cernohorsky/Modules/CommRF/RFM95W01A/Arduino_Mini.pdf

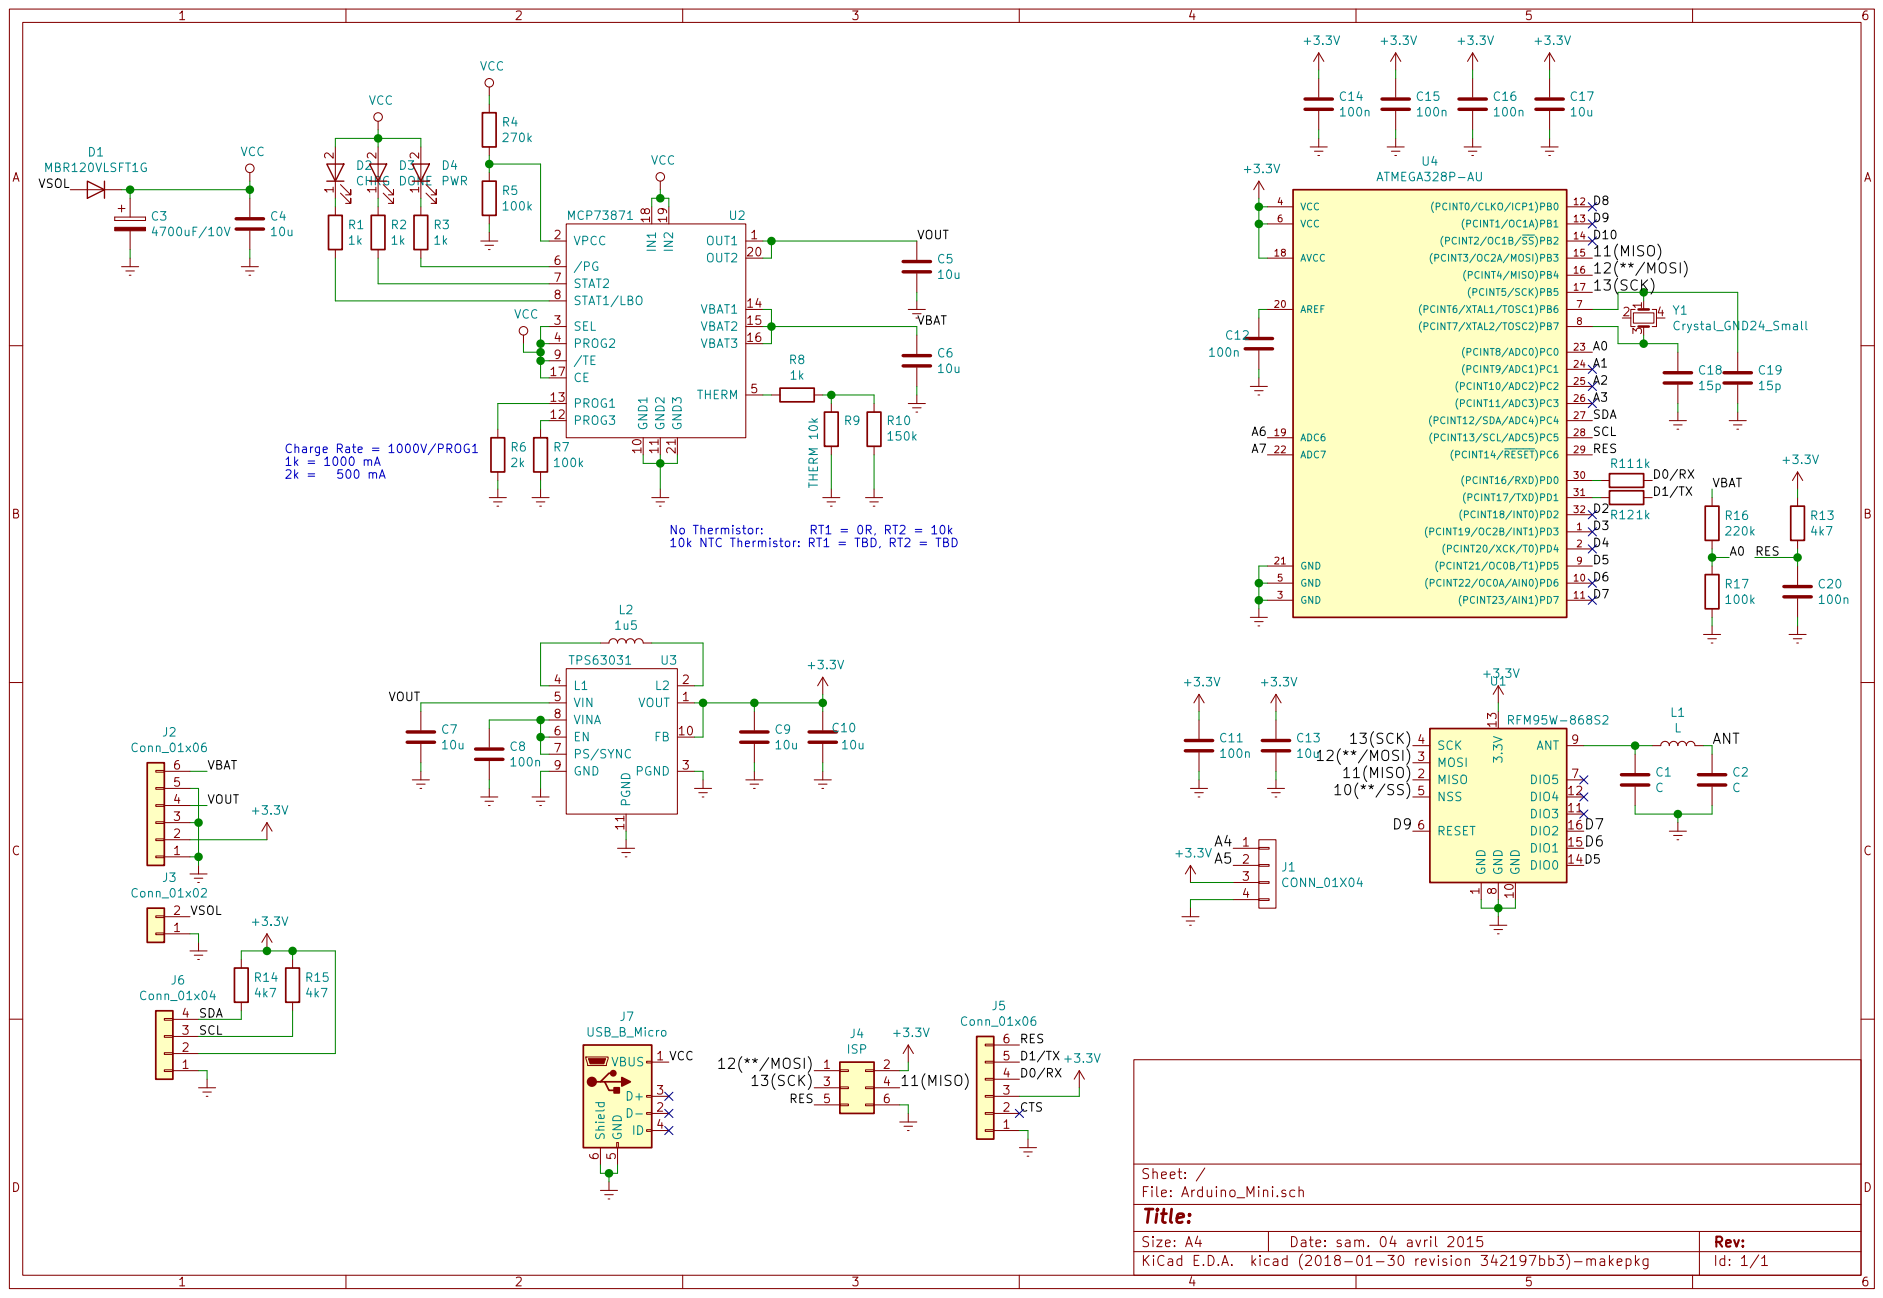
[picture p1: page 1]

1 GND 10 DIO3 11 DIO4 12 3.3V 13 DIO0 14 DIO1 15 DIO2 16 MISO 2 MOSI 3 SCK 4 NSS 5 RESET 6 DIO5 7 GND
