cernohorsky/Modules/Clock/NixieClock01A/NixieClock01A.kicad_pcb

## KiCad design Clock/NixieClock01A/NixieClock01A.kicad_pcb (2018-06-16)

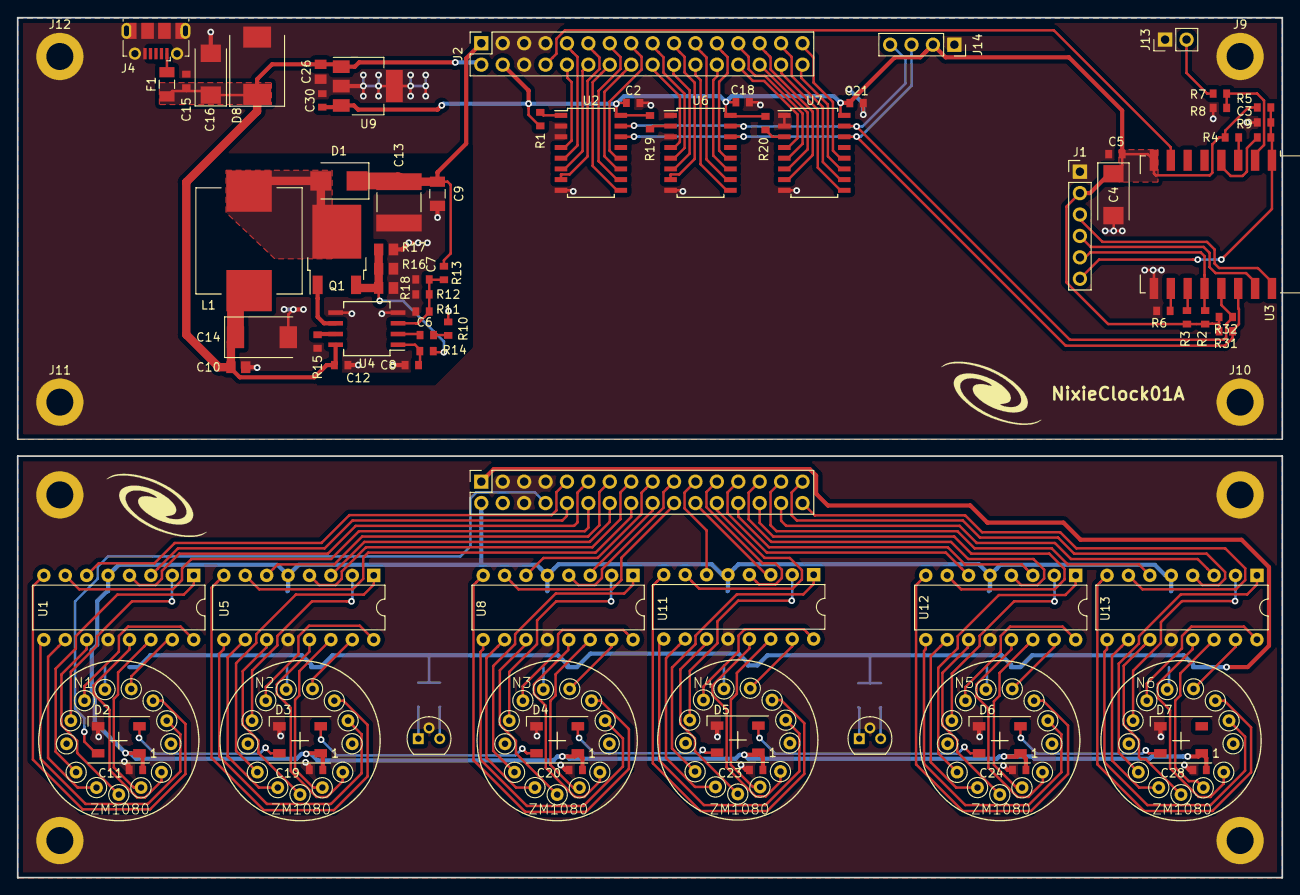
[picture p2: board NixieClock01A.kicad_pcb from above]

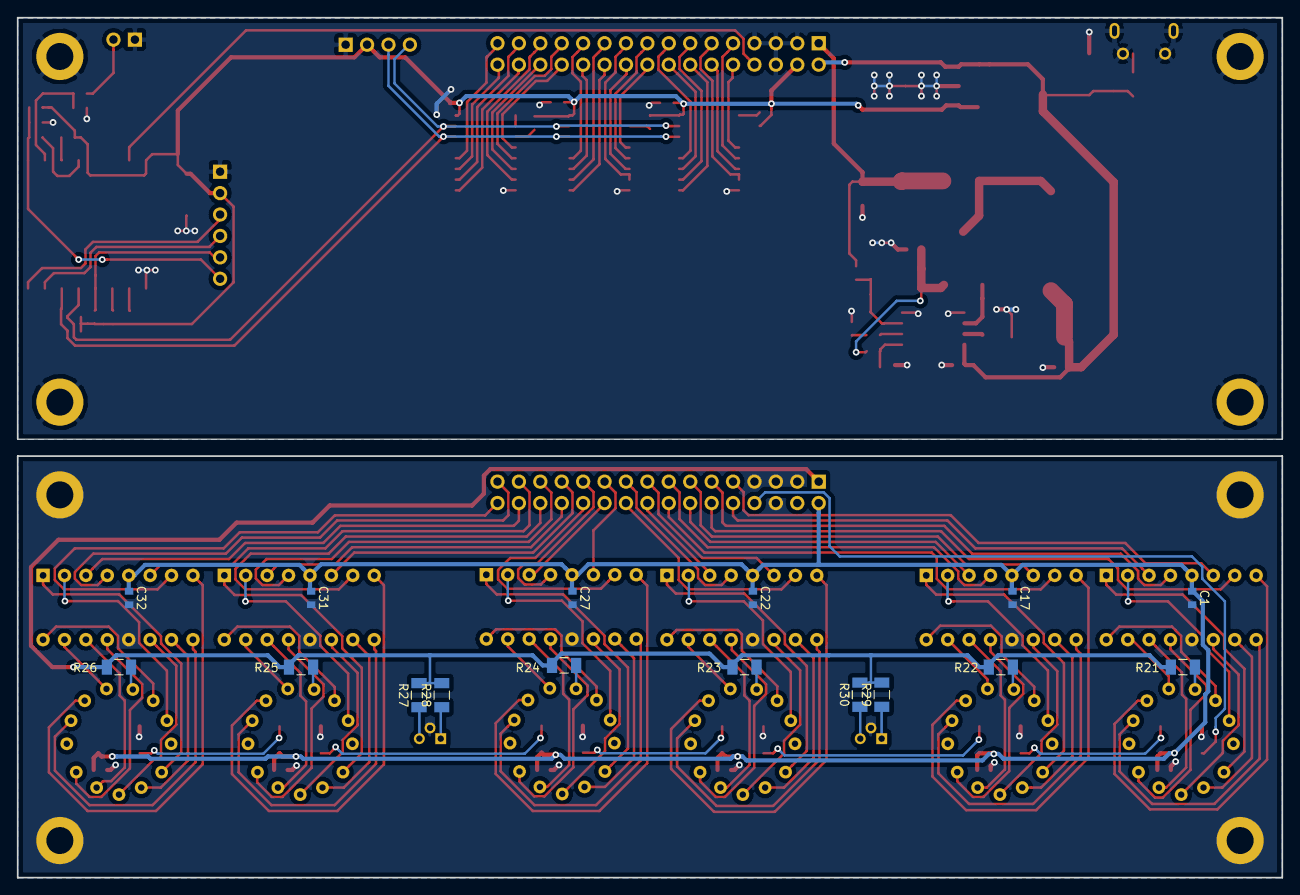
[picture p3: board NixieClock01A.kicad_pcb from below]

Board: 2 copper layers, 150.0 x 102.0 mm, 107 parts (16 on the bottom side), 128 nets.

Parts:
C1, C2, C3, C5, C11, C12, C15, C17, C18, C19, C20, C21, C22, C23, C24, C27, C28, C31, C32: 100n; C_0603_1608Metric
C4, C16: TPSC107K010R0075; CP_EIA-6032-28_Kemet-C
C6, C7: 22n; C_0603_1608Metric
C8: C; C_0603_1608Metric
C9: 100n/200V; C_1206_3216Metric
C10, C26: 10u; C_0805_2012Metric
C13: 1u/200V; C_2220_5650Metric
C14: 100u; CP_EIA-7343-31_Kemet-D
C30: 1u; C_0603_1608Metric
D1: D_Schottky; D_SMB
D2, D3, D4, D5, D6, D7: WS2812B; LED_WS2812B_PLCC4_5.0x5.0mm_P3.2mm
D8: D_TVS; D_SMC
F1: Fuse; Fuse_1206_3216Metric
J1: Conn_01x06_Male; PinHeader_1x06_P2.54mm_Vertical
J2, J3: Conn_02x16_Odd_Even; PinSocket_2x16_P2.54mm_Vertical
J4: USB_B_Micro; USB_Micro-B_Molex-105017-0001
J5, J6, J7, J8, J9, J10, J11, J12: Conn_01x01_Male; MountingHole_3.2mm_M3_DIN965_Pad
J13: Conn_01x02_Male; PinHeader_1x02_P2.54mm_Vertical
J14: Conn_01x04_Male; PinSocket_1x04_P2.54mm_Vertical
L1: L_Core_Ferrite; L_Wuerth_WE-PD-Typ-LS_Handsoldering
LA1, LA2: Lamp_Neon; TO-92
N1, N2, N3, N4, N5, N6: ZM1080
Q1: Q_NMOS_GDS; TO-252-2
R1, R11, R12, R13, R14, R19, R20: R; R_0603_1608Metric
R2, R3, R4, R5, R6: 12k; R_0603_1608Metric
R7: 330k; R_0603_1608Metric
R8: 100k; R_0603_1608Metric
R9: 470R; R_0603_1608Metric
R10: 4k7; R_0603_1608Metric
R15: 40k; R_0603_1608Metric
R16, R17, R18: R; R_0805_2012Metric
R21, R22, R23, R24, R25, R26: 27k; R_1206_3216Metric
R27, R28, R29, R30: 1M; R_1206_3216Metric
R31, R32: 4K7; R_0603_1608Metric
U1, U5, U8, U11, U12, U13: 74141; DIP-16_W7.62mm
U2, U6, U7: PCF8574; SOIC-16W_5.3x10.2mm_P1.27mm
U3: ESP-12E
U4: LM3478; SO-8_5.3x6.2mm_P1.27mm
U9: TC1262-33; SOT-223

Connections:
+3V3: C2.1, C4.1, C5.1, C18.1, C21.1, C30.1, J1.2, J2.4, J3.4, J14.2, R1.1, R2.2, R3.2, R4.2, R5.2, R19.1, R20.1, R31.2, R32.2, U2.16, U3.8, U6.16, U7.16, U9.3
+5V: C1.1, C10.1, C11.1, C12.1, C14.1, C15.1, C16.1, C17.1, C19.1, C20.1, C22.1, C23.1, C24.1, C26.1, C27.1, C28.1, C31.1, C32.1, D2.1, D3.1, D4.1, D5.1, D6.1, D7.1, D8.1, F1.1, J2.2, J3.2, L1.1, U1.5, U4.8, U5.5, U8.5, U9.1, U11.5, U12.5, U13.5
/A1: J2.10, J3.10, U1.3, U2.4
/A2: J2.9, J3.9, U1.6, U2.5
/A3: J2.12, J3.12, U1.7, U2.6
/A4: J2.11, J3.11, U1.4, U2.7
/ADC: R7.2, R8.1, U3.2
/ADC-IN: J13.2, R7.1
/B1: J2.14, J3.14, U2.9, U5.3
/B2: J2.13, J3.13, U2.10, U5.6
/B3: J2.16, J3.16, U2.11, U5.7
/B4: J2.15, J3.15, U2.12, U5.4
/C1: J2.18, J3.18, U6.4, U8.3
/C2: J2.17, J3.17, U6.5, U8.6
/C3: J2.20, J3.20, U6.6, U8.7
/C4: J2.19, J3.19, U6.7, U8.4
/D1: J2.22, J3.22, U6.9, U11.3
/D2: J2.21, J3.21, U6.10, U11.6
/D3: J2.24, J3.24, U6.11, U11.7
/D4: J2.23, J3.23, U6.12, U11.4
/E1: J2.26, J3.26, U7.4, U12.3
/E2: J2.25, J3.25, U7.5, U12.6
/E3: J2.28, J3.28, U7.6, U12.7
/E4: J2.27, J3.27, U7.7, U12.4
/EN: R4.1, U3.3
/F1: J2.30, J3.30, U7.9, U13.3
/F2: J2.29, J3.29, U7.10, U13.6
/F3: J2.32, J3.32, U7.11, U13.7
/F4: J2.31, J3.31, U7.12, U13.4
/GPIO0: J1.5, R2.1, U3.18
/GPIO2: R3.1, U3.17
/GPIO15: R6.1, U3.16
/NeoPix: D2.4, J2.8, J3.8, U3.7
/RST: C3.1, J1.6, R5.1, R9.1, U3.1
/RX: J1.4, U3.21
/SCL: J14.3, R31.1, U2.14, U3.20, U6.14, U7.14
/SDA: J14.4, R32.1, U2.15, U3.19, U6.15, U7.15
/TX: J1.3, U3.22
/Uanode: C9.1, C13.1, D1.1, J2.1, J3.1, R13.1, R21.1, R22.1, R23.1, R24.1, R25.1, R26.1, R27.2, R28.2, R29.2, R30.2
GND: C1.2, C2.2, C3.2, C4.2, C5.2, C7.1, C8.1, C9.2, C10.2, C11.2, C12.2, C13.2, C14.2, C15.2, C16.2, C17.2, C18.2, C19.2, C20.2, C21.2, C22.2, C23.2, C24.2, C26.2, C27.2, C28.2, C30.2, C31.2, C32.2, D2.3, D3.3, D4.3, D5.3, D6.3, D7.3, D8.2, J1.1, J2.3, J2.5, J2.6, J2.7, J3.3, J3.5, J3.6, J3.7, J4.5, J4.6, J5.1, J6.1, J7.1, J8.1, J9.1, J10.1, J11.1, J12.1, J13.1, J14.1, LA1.2, LA2.2, R6.2, R8.2, R10.1, R11.1, R12.1, R15.2, R16.2, R17.2, R18.2, U1.12, U2.2, U2.3, U2.8, U3.15, U4.4, U4.5, U5.12, U6.1, U6.3, U6.8, U7.1, U7.2, U7.8, U8.12, U9.2, U9.4, U11.12, U12.12, U13.12
unnamed: C6.1, U4.2
unnamed: C6.2, R10.2
unnamed: C7.2, R11.2, R12.2, R13.2, U4.3
unnamed: C8.2, R14.2, U4.1
unnamed: D1.2, L1.2, Q1.2
unnamed: D2.2, D3.4
unnamed: D3.2, D4.4
unnamed: D4.2, D5.4
unnamed: D5.2, D6.4
unnamed: D6.2, D7.4
unnamed: F1.2, J4.1
unnamed: LA1.1, R28.1
unnamed: LA1.3, R27.1
unnamed: LA2.1, R29.1
unnamed: LA2.3, R30.1
unnamed: N1.1, U1.15
unnamed: N1.2, U1.8
unnamed: N1.3, U1.9
unnamed: N1.5, U1.13
unnamed: N1.6, U1.14
unnamed: N1.7, U1.11
unnamed: N1.8, U1.10
unnamed: N1.9, U1.1
unnamed: N1.11, U1.2
unnamed: N1.12, U1.16
unnamed: N1.13, R21.2
unnamed: N2.1, U5.15
unnamed: N2.2, U5.8
unnamed: N2.3, U5.9
unnamed: N2.5, U5.13
unnamed: N2.6, U5.14
unnamed: N2.7, U5.11
unnamed: N2.8, U5.10
unnamed: N2.9, U5.1
unnamed: N2.11, U5.2
unnamed: N2.12, U5.16
unnamed: N2.13, R22.2
unnamed: N3.1, U8.15
unnamed: N3.2, U8.8
unnamed: N3.3, U8.9
unnamed: N3.5, U8.13
unnamed: N3.6, U8.14
unnamed: N3.7, U8.11
unnamed: N3.8, U8.10
unnamed: N3.9, U8.1
unnamed: N3.11, U8.2
unnamed: N3.12, U8.16
unnamed: N3.13, R23.2
unnamed: N4.1, U11.15
unnamed: N4.2, U11.8
unnamed: N4.3, U11.9
unnamed: N4.5, U11.13
unnamed: N4.6, U11.14
unnamed: N4.7, U11.11
unnamed: N4.8, U11.10
unnamed: N4.9, U11.1
unnamed: N4.11, U11.2
unnamed: N4.12, U11.16
unnamed: N4.13, R24.2
unnamed: N5.1, U12.15
unnamed: N5.2, U12.8
unnamed: N5.3, U12.9
unnamed: N5.5, U12.13
unnamed: N5.6, U12.14
unnamed: N5.7, U12.11
unnamed: N5.8, U12.10
unnamed: N5.9, U12.1
unnamed: N5.11, U12.2
unnamed: N5.12, U12.16
unnamed: N5.13, R25.2
unnamed: N6.1, U13.15
unnamed: N6.2, U13.8
unnamed: N6.3, U13.9
unnamed: N6.5, U13.13
unnamed: N6.6, U13.14
unnamed: N6.7, U13.11
unnamed: N6.8, U13.10
unnamed: N6.9, U13.1
unnamed: N6.11, U13.2
unnamed: N6.12, U13.16
unnamed: N6.13, R26.2
unnamed: Q1.1, U4.6
unnamed: Q1.3, R14.1, R16.1, R17.1, R18.1
unnamed: R1.2, U2.1
unnamed: R9.2, U3.4
unnamed: R15.1, U4.7
unnamed: R19.2, U6.2
unnamed: R20.2, U7.3
