cernohorsky/Modules/CommRF/ESP826601A/ESP8266.kicad_pcb

## KiCad design CommRF/ESP826601A/ESP8266.kicad_pcb (2018-06-09)

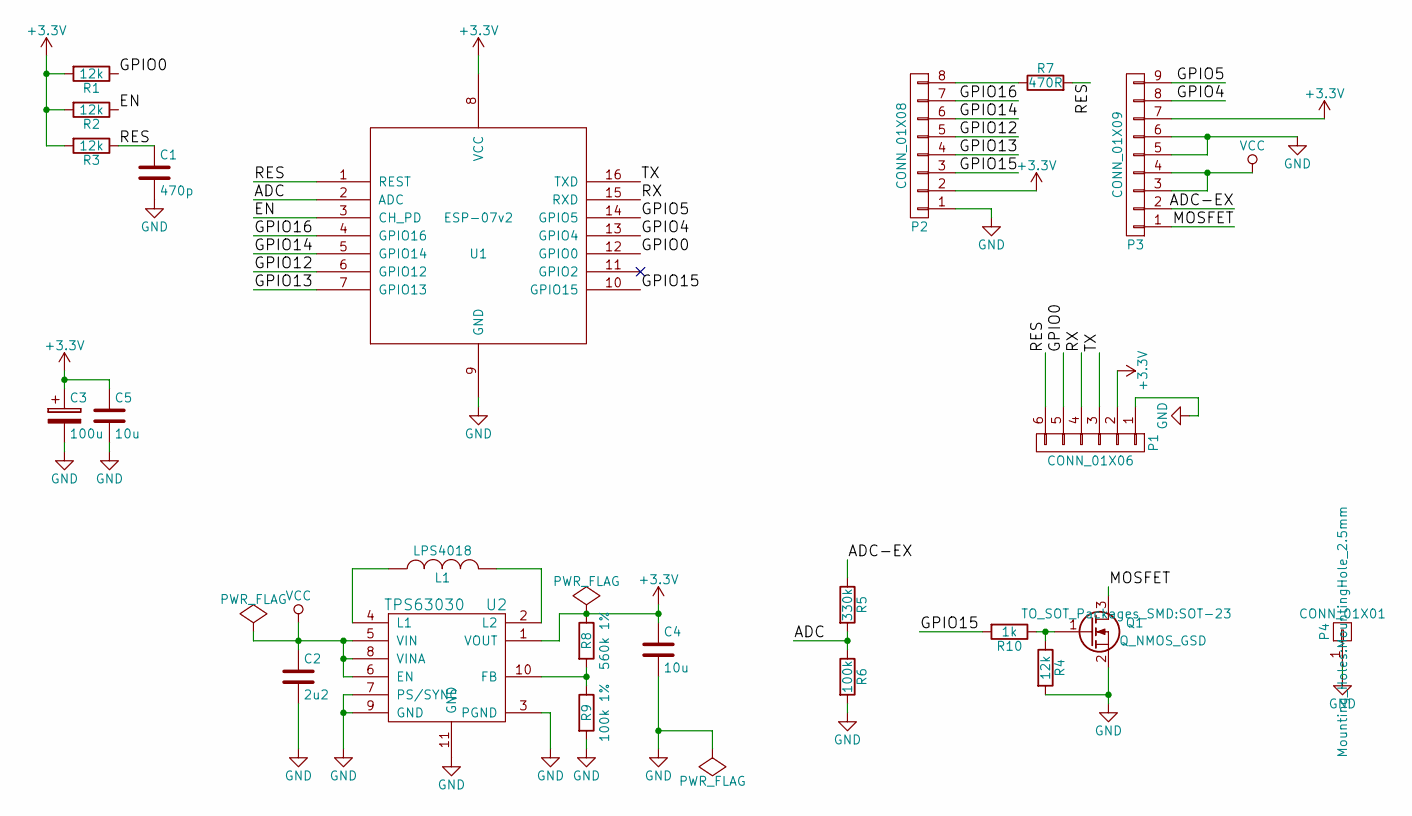
[picture p4: schematic ESP8266.sch]

Parts:
C1: 470p; C_0603
C2: 2u2; C_0603
C3: 100u; TantalC_SizeB_EIA-3528_Wave
C4, C5: 10u; C_0805
L1: LPS4018
P1: CONN_01X06; Pin_Header_Straight_1x06
P2: CONN_01X08; Pin_Header_Straight_1x08
P3: CONN_01X09; Pin_Header_Straight_1x09
P4: CONN_01X01; MountingHole_2.5mm
Q1: Q_NMOS_GSD; SOT-23
R1, R2, R3, R4: 12k; R_0603
R5: 330k; R_0603
R6: 100k; R_0603
R7: 470R; R_0603
R8: 560k 1%; R_0603
R9: 100k 1%; R_0603
R10: 1k; R_0603
U1: ESP-07v2
U2: TPS63030; DSK-10Pin-VSON

Connections:
+3V3: C3.1, C4.1, C5.1, P1.2, P2.2, P3.7, R1.2, R2.2, R3.2, R8.1, U1.8 (VCC), U2.1 (VOUT)
/ADC: R5.2, R6.1, U1.2 (ADC)
/ADC-EX: P3.2, R5.1
/EN: R2.1, U1.3 (CH_PD)
/GPIO0: P1.5, R1.1, U1.12 (GPIO0)
/GPIO4: P3.8, U1.13 (GPIO4)
/GPIO5: P3.9, U1.14 (GPIO5)
/GPIO12: P2.5, U1.6 (GPIO12)
/GPIO13: P2.4, U1.7 (GPIO13)
/GPIO14: P2.6, U1.5 (GPIO14)
/GPIO15: P2.3, R10.2, U1.10 (GPIO15)
/GPIO16: P2.7, U1.4 (GPIO16)
/MOSFET: P3.1, Q1.3 (D)
/RES: C1.1, P1.6, R3.1, R7.2, U1.1 (REST)
/RX: P1.4, U1.15 (RXD)
/TX: P1.3, U1.16 (TXD)
GND: C1.2, C2.2, C3.2, C4.2, C5.2, P1.1, P2.1, P3.5, P3.6, P4.1, Q1.2 (S), R4.2, R6.2, R9.2, U1.9 (GND), U2.3 (PGND), U2.7 (PS/SYNC), U2.9 (GND), U2.11 (GND)
unnamed: L1.1, U2.4 (L1)
unnamed: L1.2, U2.2 (L2)
unnamed: P2.8, R7.1
unnamed: Q1.1 (G), R4.1, R10.1
unnamed: R8.2, R9.1, U2.10 (FB)
VCC: C2.1, P3.3, P3.4, U2.5 (VIN), U2.6 (EN), U2.8 (VINA)

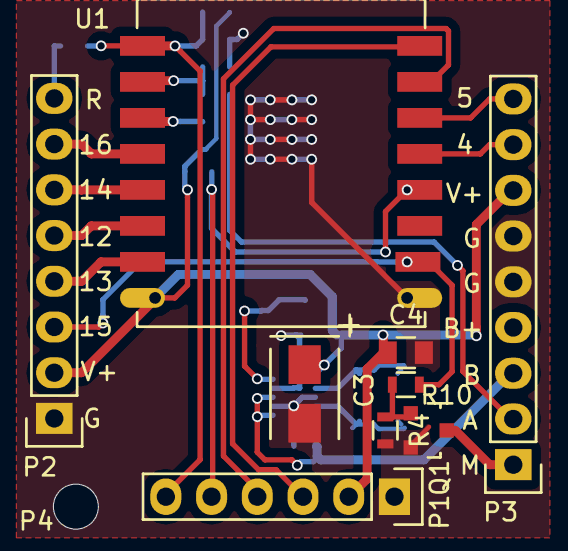
[picture p5: board ESP8266.kicad_pcb from above]

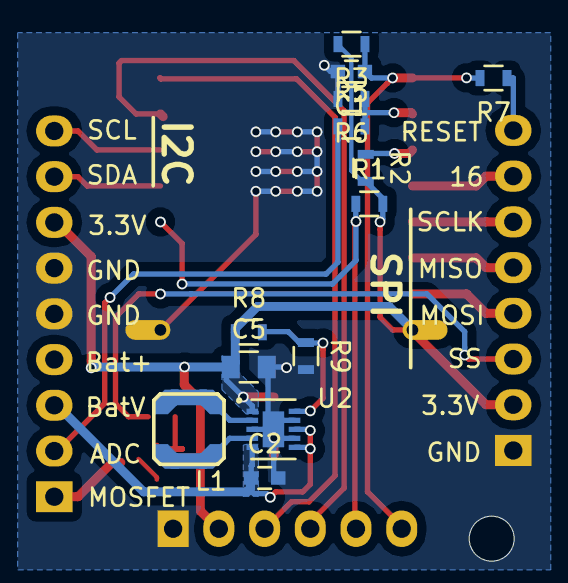
[picture p6: board ESP8266.kicad_pcb from below]

Board: 2 copper layers, 23 parts (13 on the bottom side), 23 nets.
