cernohorsky/Modules/PowerSupply/LMR1405001A/LMR1405001A.kicad_pcb

## KiCad design PowerSupply/LMR1405001A/LMR1405001A.kicad_pcb (2018-01-28)

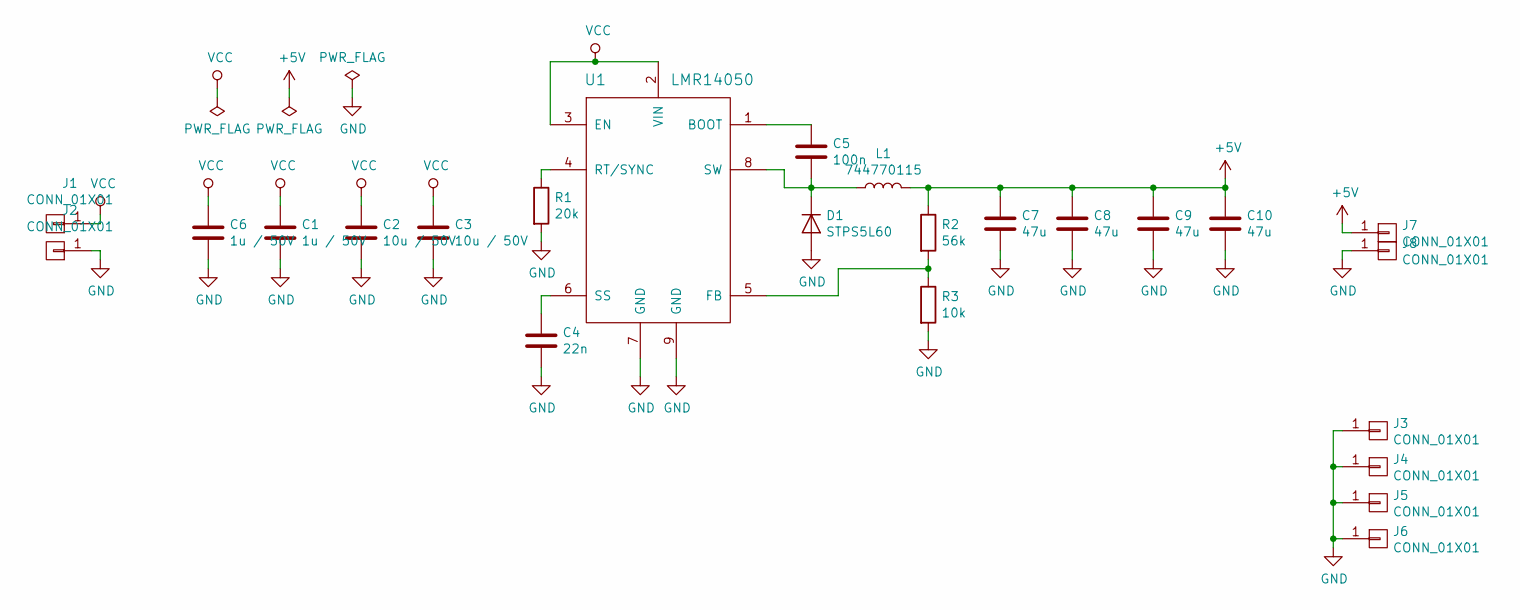
[picture p7: schematic LMR1405001A.sch]

Parts:
C1, C6: 1u / 50V; C_1210
C2, C3: 10u / 50V; C_1210
C4: 22n; C_0603
C5: 100n; C_0603
C7, C8, C9, C10: 47u; C_1210
D1: STPS5L60; DO-214AB
J1, J2, J7, J8: CONN_01X01; WAGO256_2
J3, J4, J5, J6: CONN_01X01; MountingHole_3.2mm_M3_Pad
L1: 744770115; SELF-WE-PD-XXL
R1: 20k; C_0603
R2: 56k; C_0603
R3: 10k; C_0603
U1: LMR14050; HSOP-8

Connections:
+5V: C7.1, C8.1, C9.1, C10.1, J7.1, L1.2, R2.1
GND: C1.2, C2.2, C3.2, C4.2, C6.2, C7.2, C8.2, C9.2, C10.2, D1.2 (A), J2.1, J3.1, J4.1, J5.1, J6.1, J8.1, R1.2, R3.2, U1.7 (GND), U1.9 (GND)
unnamed: C4.1, U1.6 (SS)
unnamed: C5.1, U1.1 (BOOT)
unnamed: C5.2, D1.1 (K), L1.1, U1.8 (SW)
unnamed: R1.1, U1.4 (RT/SYNC)
unnamed: R2.2, R3.1, U1.5 (FB)
VCC: C1.1, C2.1, C3.1, C6.1, J1.1, U1.2 (VIN), U1.3 (EN)

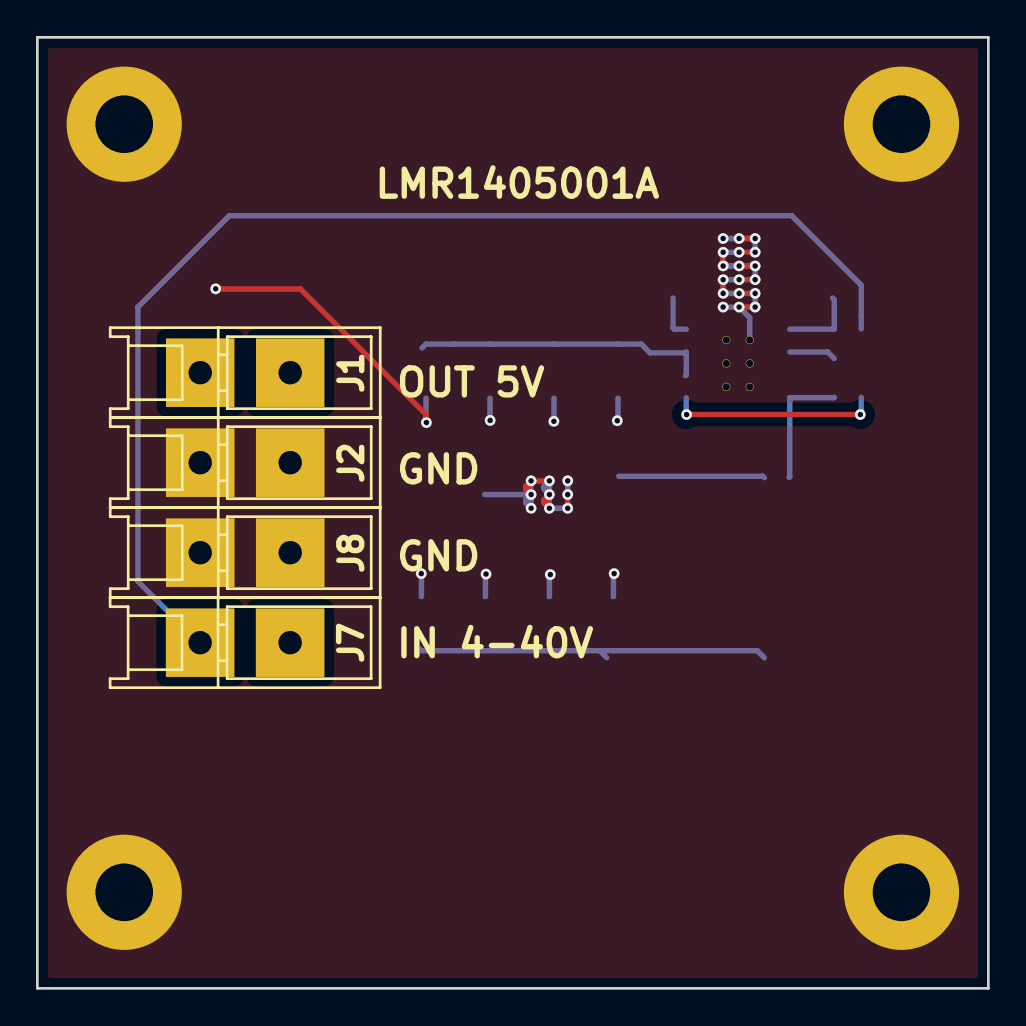
[picture p8: board LMR1405001A.kicad_pcb from above]

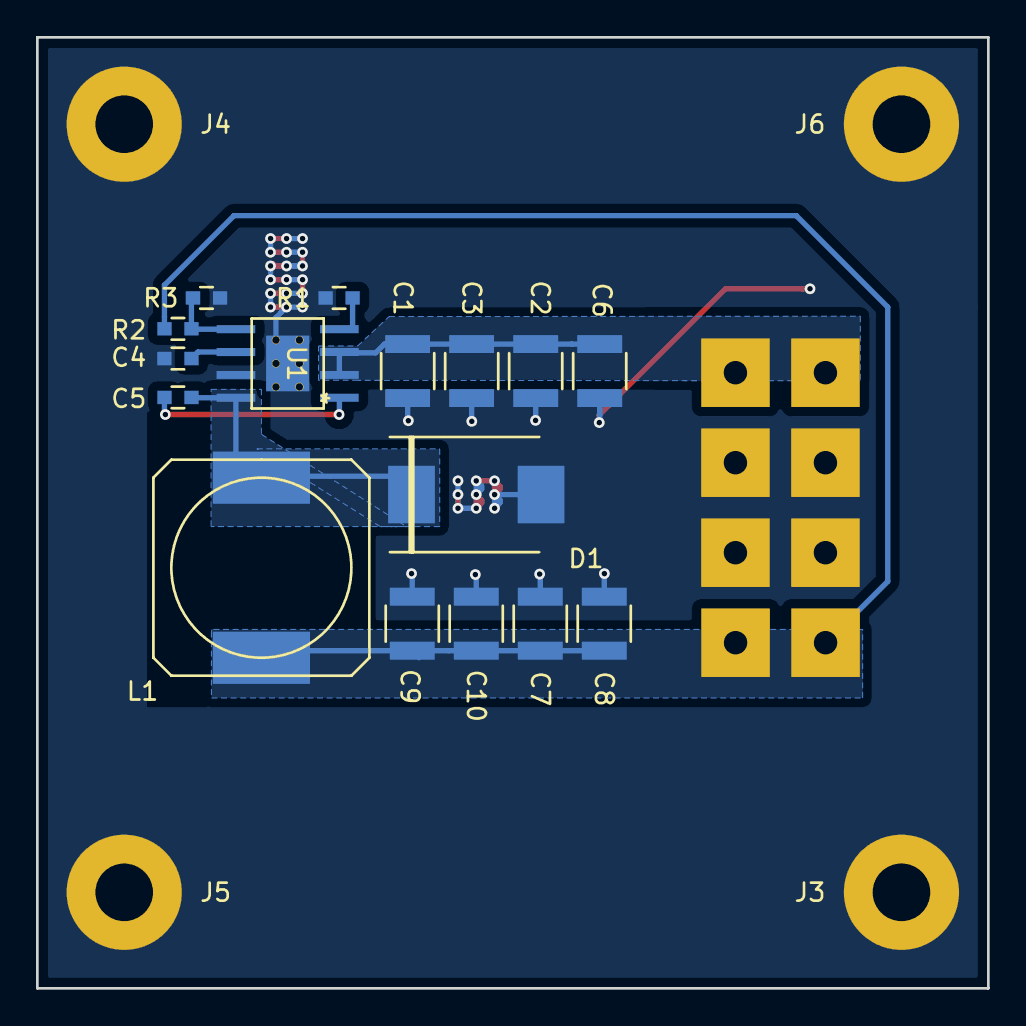
[picture p9: board LMR1405001A.kicad_pcb from below]

Board: 2 copper layers, 52.8 x 52.8 mm, 24 parts (20 on the bottom side), 8 nets.
