cernohorsky/Modules/PowerSW/BTT605001A/BTT605001A.kicad_pcb

## KiCad design PowerSW/BTT605001A/BTT605001A.kicad_pcb (2018-01-28)

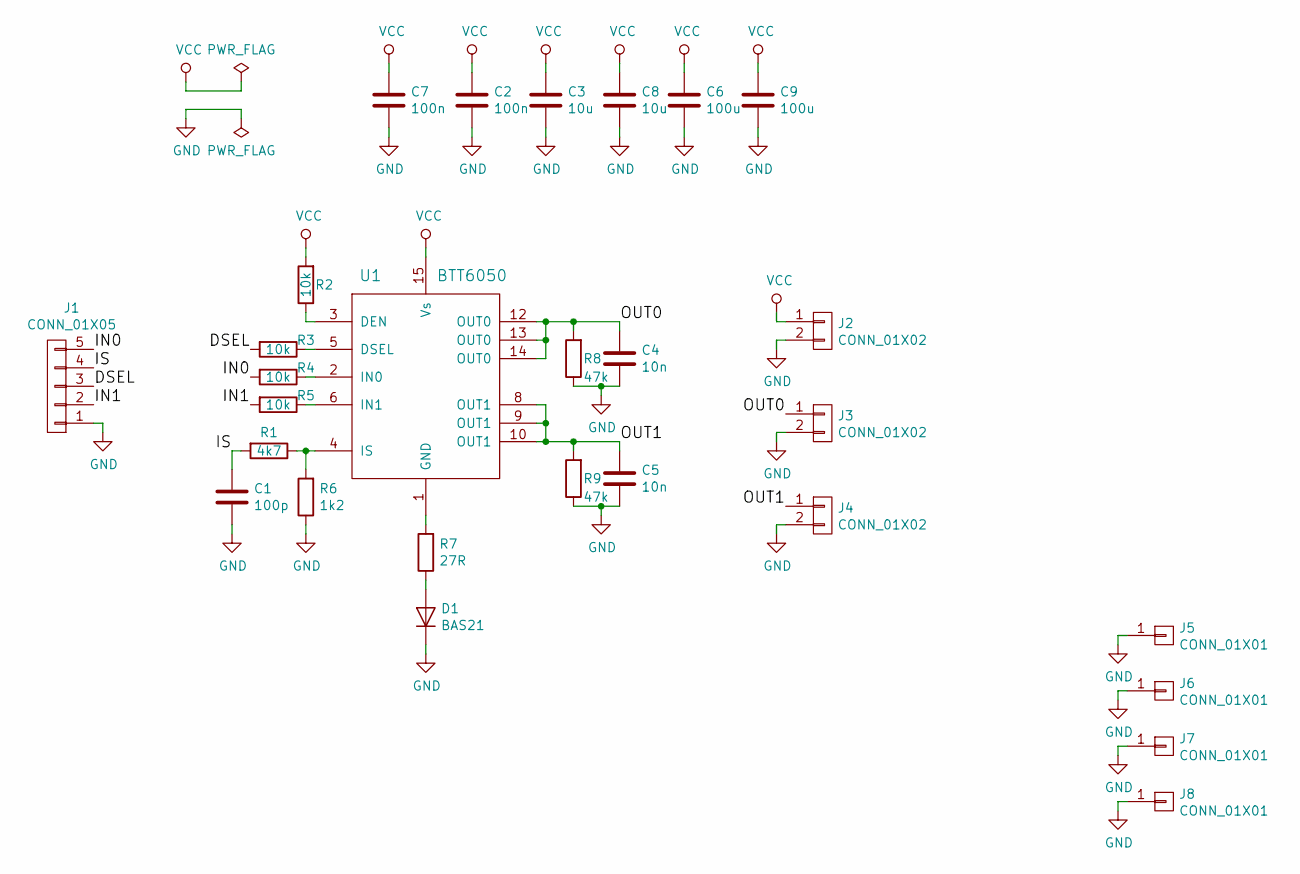
[picture p10: schematic BTT605001A.sch]

Parts:
C1: 100p; C_0603
C2, C7: 100n; C_0603
C3, C8: 10u; C_1210
C4, C5: 10n; C_0603
C6, C9: 100u; c_elec_10x10.5
D1: BAS21; C_0603
J1: CONN_01X05; Pin_Header_Straight_1x05
J2, J3, J4: CONN_01X02; WireConnection_2.50mmDrill
J5, J6, J7, J8: CONN_01X01; MountingHole_3.2mm_M3_DIN965_Pad
R1: 4k7; R_0603
R2, R3, R4, R5: 10k; R_0603
R6: 1k2; R_0603
R7: 27R; R_0603
R8, R9: 47k; R_0603
U1: BTT6050; PG-DSO-14-47_3.9x8.7mm_Pitch1.27mm

Connections:
/DSEL: J1.3, R3.2
/IN0: J1.5, R4.2
/IN1: J1.2, R5.2
/IS: C1.1, J1.4, R1.2
/OUT0: C4.1, J3.1, R8.2, U1.12 (OUT0), U1.13 (OUT0), U1.14 (OUT0)
/OUT1: C5.1, J4.1, R9.2, U1.8 (OUT1), U1.9 (OUT1), U1.10 (OUT1)
GND: C1.2, C2.2, C3.2, C4.2, C5.2, C6.2, C7.2, C8.2, C9.2, D1.1 (K), J1.1, J2.2, J3.2, J4.2, J5.1, J6.1, J7.1, J8.1, R6.1, R8.1, R9.1
unnamed: D1.2 (A), R7.1
unnamed: R1.1, R6.2, U1.4 (IS)
unnamed: R2.1, U1.3 (DEN)
unnamed: R3.1, U1.5 (DSEL)
unnamed: R4.1, U1.2 (IN0)
unnamed: R5.1, U1.6 (IN1)
unnamed: R7.2, U1.1 (GND)
VCC: C2.1, C3.1, C6.1, C7.1, C8.1, C9.1, J2.1, R2.2, U1.15 (Vs)

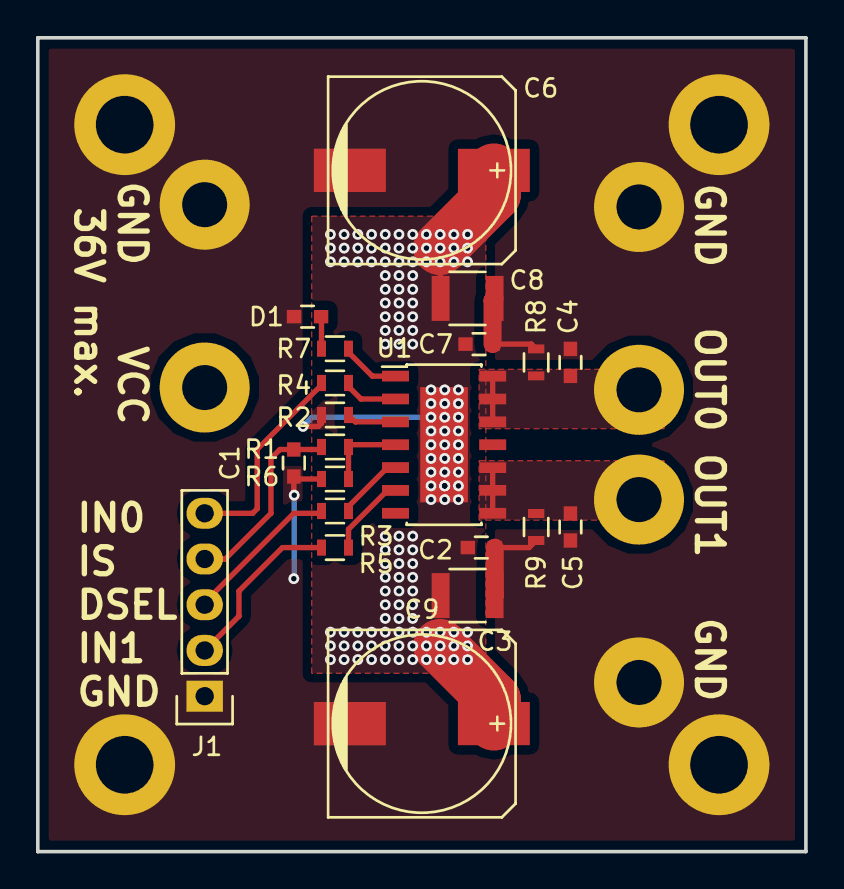
[picture p11: board BTT605001A.kicad_pcb from above]

Board: 2 copper layers, 42.7 x 45.2 mm, 28 parts (0 on the bottom side), 15 nets.
