cernohorsky/Modules/H_Bridge/LM5104-IRFZ44N01A/LM510401A.kicad_pcb

## KiCad design H_Bridge/LM5104-IRFZ44N01A/LM510401A.kicad_pcb (2018-01-28)

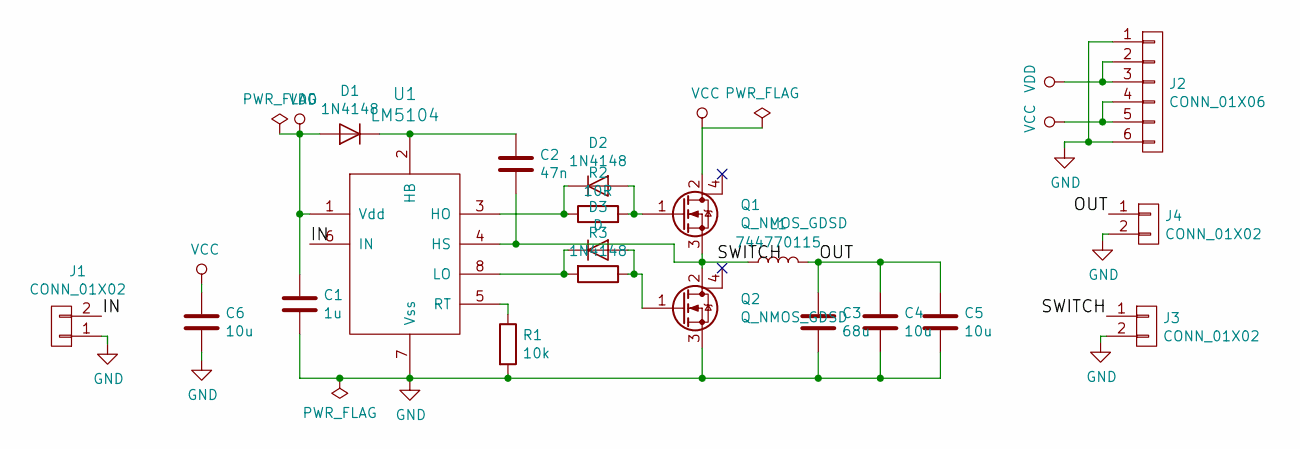
[picture p12: schematic LM510401A.sch]

Parts:
C1: 1u; C_0805
C2: 47n; C_0603
C3: 68u; C_1210
C4, C5, C6: 10u; C_1210
D1, D2: 1N4148; C_0603
D3: D; C_0603
J1, J3, J4: CONN_01X02; Pin_Header_Straight_1x02
J2: CONN_01X06; Pin_Header_Straight_1x06
L1: 744770115; SELF-WE-PD-XXL
Q1, Q2: Q_NMOS_GDSD; TO-220_Neutral123_Vertical
R1: 10k; R_0603
R2: 10R; R_0603
R3: 1N4148; R_0603
U1: LM5104; SOIC-8-N

Connections:
/IN: J1.2, U1.6 (IN)
/OUT: C3.1, C4.1, C5.1, J4.1, L1.2
/SWITCH: C2.2, J3.1, L1.1, Q1.3 (S), Q2.2 (D), U1.4 (HS)
GND: C1.2, C3.2, C4.2, C5.2, C6.2, J1.1, J2.1, J2.6, J3.2, J4.2, Q2.3 (S), R1.2, U1.7 (Vss)
unnamed: C2.1, D1.1 (K), U1.2 (HB)
unnamed: D2.1 (K), R2.1, U1.3 (HO)
unnamed: D2.2 (A), Q1.1 (G), R2.2
unnamed: D3.1 (K), R3.2, U1.8 (LO)
unnamed: D3.2 (A), Q2.1 (G), R3.1
unnamed: R1.1, U1.5 (RT)
VCC: C6.1, J2.4, J2.5, Q1.2 (D)
VDD: C1.1, D1.2 (A), J2.2, J2.3, U1.1 (Vdd)

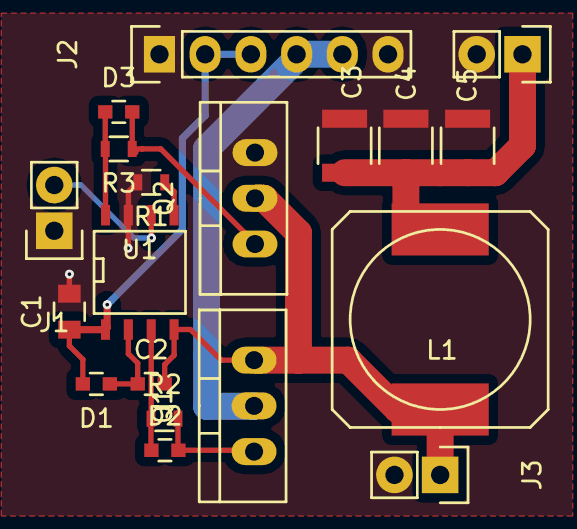
[picture p13: board H_Bridge/LM5104-IRFZ44N01A/LM510401A.kicad_pcb from above]

Board: 2 copper layers, 20 parts (1 on the bottom side), 12 nets.
