cernohorsky/Modules/H_Bridge/LM5104-IRF785501A/LM510401A.kicad_pcb

## KiCad design H_Bridge/LM5104-IRF785501A/LM510401A.kicad_pcb (2018-01-28)

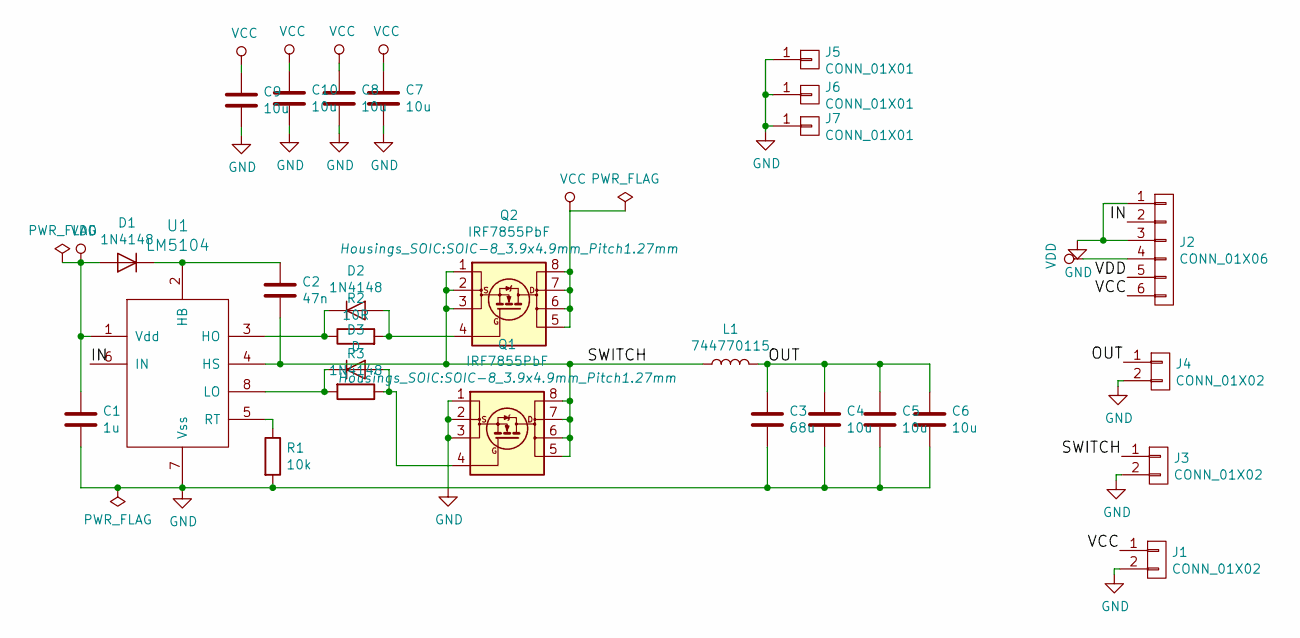
[picture p14: schematic LM510401A.sch]

Parts:
C1: 1u; C_0805
C2: 47n; C_0603
C3: 68u; C_1210
C4, C5, C6, C7, C8, C9, C10: 10u; C_1210
D1, D2: 1N4148; C_0603
D3: D; C_0603
J1, J4: CONN_01X02; WireConnection_2.00mmDrill
J2: CONN_01X06; Pin_Header_Straight_1x06
J3: CONN_01X02; Pin_Header_Straight_1x02
J5, J6, J7: CONN_01X01; MountingHole_3.2mm_M3_Pad
L1: 744770115; SELF-WE-PD-XXL
Q1, Q2: IRF7855PbF; SOIC-8_3.9x4.9mm_Pitch1.27mm
R1: 10k; R_0603
R2: 10R; R_0603
R3: 1N4148; R_0603
U1: LM5104; SOIC-8-N

Connections:
/IN: J2.2, U1.6 (IN)
/OUT: C3.1, C4.1, C5.1, C6.1, J4.1, L1.2
/SWITCH: C2.2, J3.1, L1.1, Q1.5 (D), Q1.6 (D), Q1.7 (D), Q1.8 (D), Q2.1 (S), Q2.2 (S), Q2.3 (S), U1.4 (HS)
GND: C1.2, C3.2, C4.2, C5.2, C6.2, C7.2, C8.2, C9.2, C10.2, J1.2, J2.1, J2.3, J3.2, J4.2, J5.1, J6.1, J7.1, Q1.1 (S), Q1.2 (S), Q1.3 (S), R1.2, U1.7 (Vss)
unnamed: C2.1, D1.1 (K), U1.2 (HB)
unnamed: D2.1 (K), R2.1, U1.3 (HO)
unnamed: D2.2 (A), Q2.4 (G), R2.2
unnamed: D3.1 (K), R3.2, U1.8 (LO)
unnamed: D3.2 (A), Q1.4 (G), R3.1
unnamed: R1.1, U1.5 (RT)
VCC: C7.1, C8.1, C9.1, C10.1, J1.1, J2.6, Q2.5 (D), Q2.6 (D), Q2.7 (D), Q2.8 (D)
VDD: C1.1, D1.2 (A), J2.4, J2.5, U1.1 (Vdd)

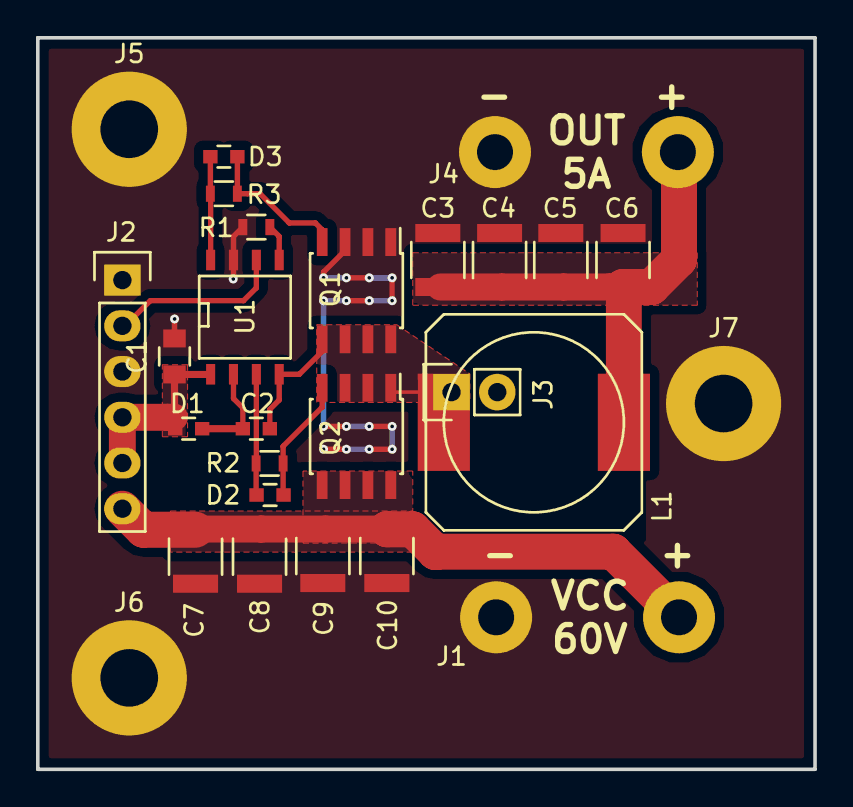
[picture p15: board H_Bridge/LM5104-IRF785501A/LM510401A.kicad_pcb from above]

Board: 2 copper layers, 43.2 x 40.6 mm, 27 parts (0 on the bottom side), 12 nets.
