cernohorsky/Modules/CommRF/RFM95W01A/Arduino_Mini.kicad_pcb

## KiCad design CommRF/RFM95W01A/Arduino_Mini.kicad_pcb (2018-01-28)

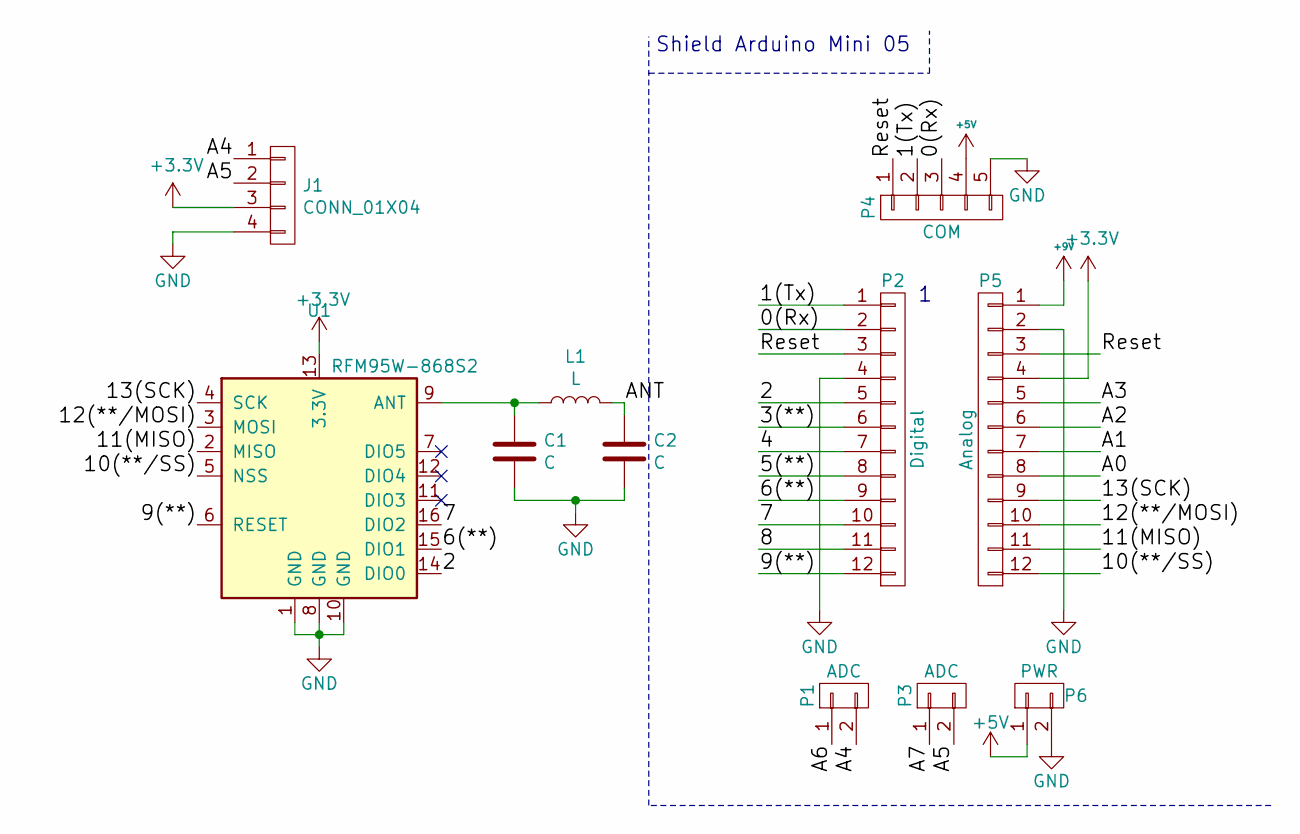
[picture p16: schematic Arduino_Mini.sch]

Parts:
C1, C2: C; C_0402
J1: CONN_01X04; RJ12GLP-AMP(RJ12)
L1: L; C_0402
P1, P3: ADC; Socket_Strip_Arduino_1x02
P2: Digital; Socket_Strip_Arduino_1x12
P4: COM; Socket_Strip_Arduino_1x05
P5: Analog; Socket_Strip_Arduino_1x12
P6: PWR; Socket_Strip_Arduino_1x02
U1: RFM95W-868S2; RFM95W

Connections:
+3V3: J1.3, P5.4, U1.13 (3.3V)
+5V: P4.4, P6.1
+9V: P5.1
/0(Rx): P2.2, P4.3
/1(Tx): P2.1, P4.2
/2: P2.5, U1.14 (DIO0)
/3(**): P2.6
/4: P2.7
/5(**): P2.8
/6(**): P2.9, U1.15 (DIO1)
/7: P2.10, U1.16 (DIO2)
/8: P2.11
/9(**): P2.12, U1.6 (RESET)
/10(**/SS): P5.12, U1.5 (NSS)
/11(MISO): P5.11, U1.2 (MISO)
/12(**/MOSI): P5.10, U1.3 (MOSI)
/13(SCK): P5.9, U1.4 (SCK)
/A0: P5.8
/A1: P5.7
/A2: P5.6
/A3: P5.5
/A4: J1.1, P1.2
/A5: J1.2, P3.2
/A6: P1.1
/A7: P3.1
/ANT: C2.1, L1.2
/Reset: P2.3, P4.1, P5.3
GND: C1.2, C2.2, J1.4, P2.4, P4.5, P5.2, P6.2, U1.1 (GND), U1.8 (GND), U1.10 (GND)
unnamed: C1.1, L1.1, U1.9 (ANT)

Notes on the sheet:
Shield Arduino Mini 05

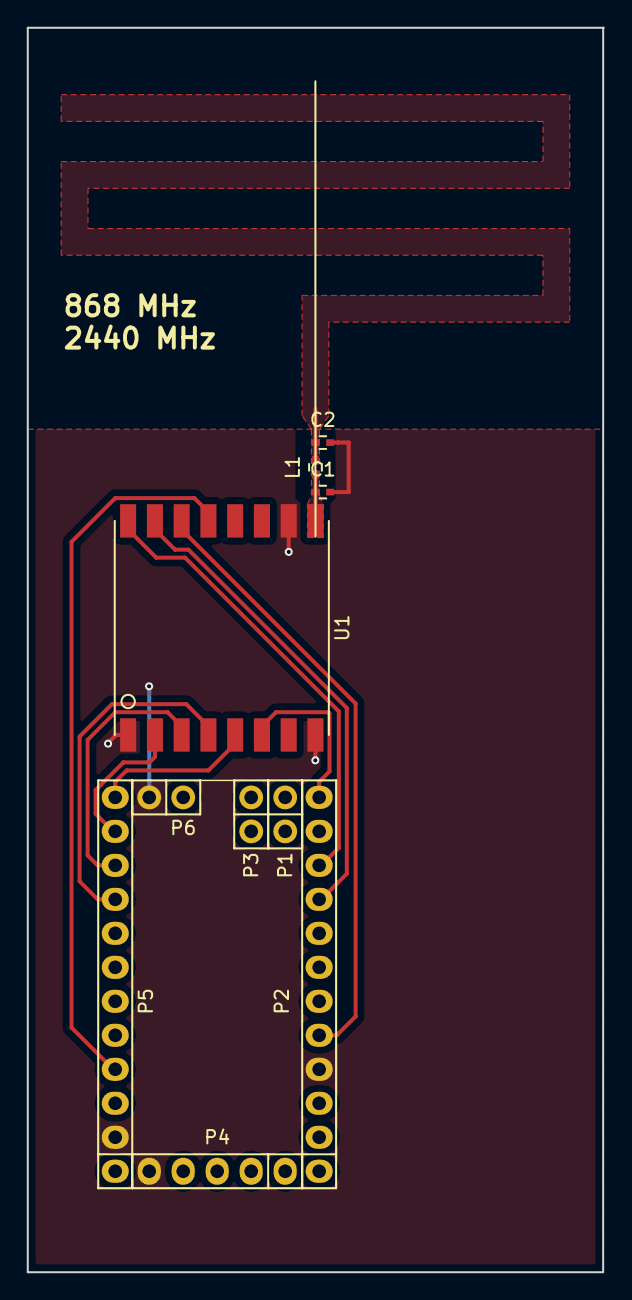
[picture p17: board Arduino_Mini.kicad_pcb from above]

Board: 2 copper layers, 43.0 x 93.0 mm, 10 parts (0 on the bottom side), 16 nets.
