cernohorsky/Modules/CommSerial/USBHUB01A/SCH_PCB/usbhub01a.kicad_pcb

## KiCad design CommSerial/USBHUB01A/SCH_PCB/usbhub01a.kicad_pcb (2018-01-28)

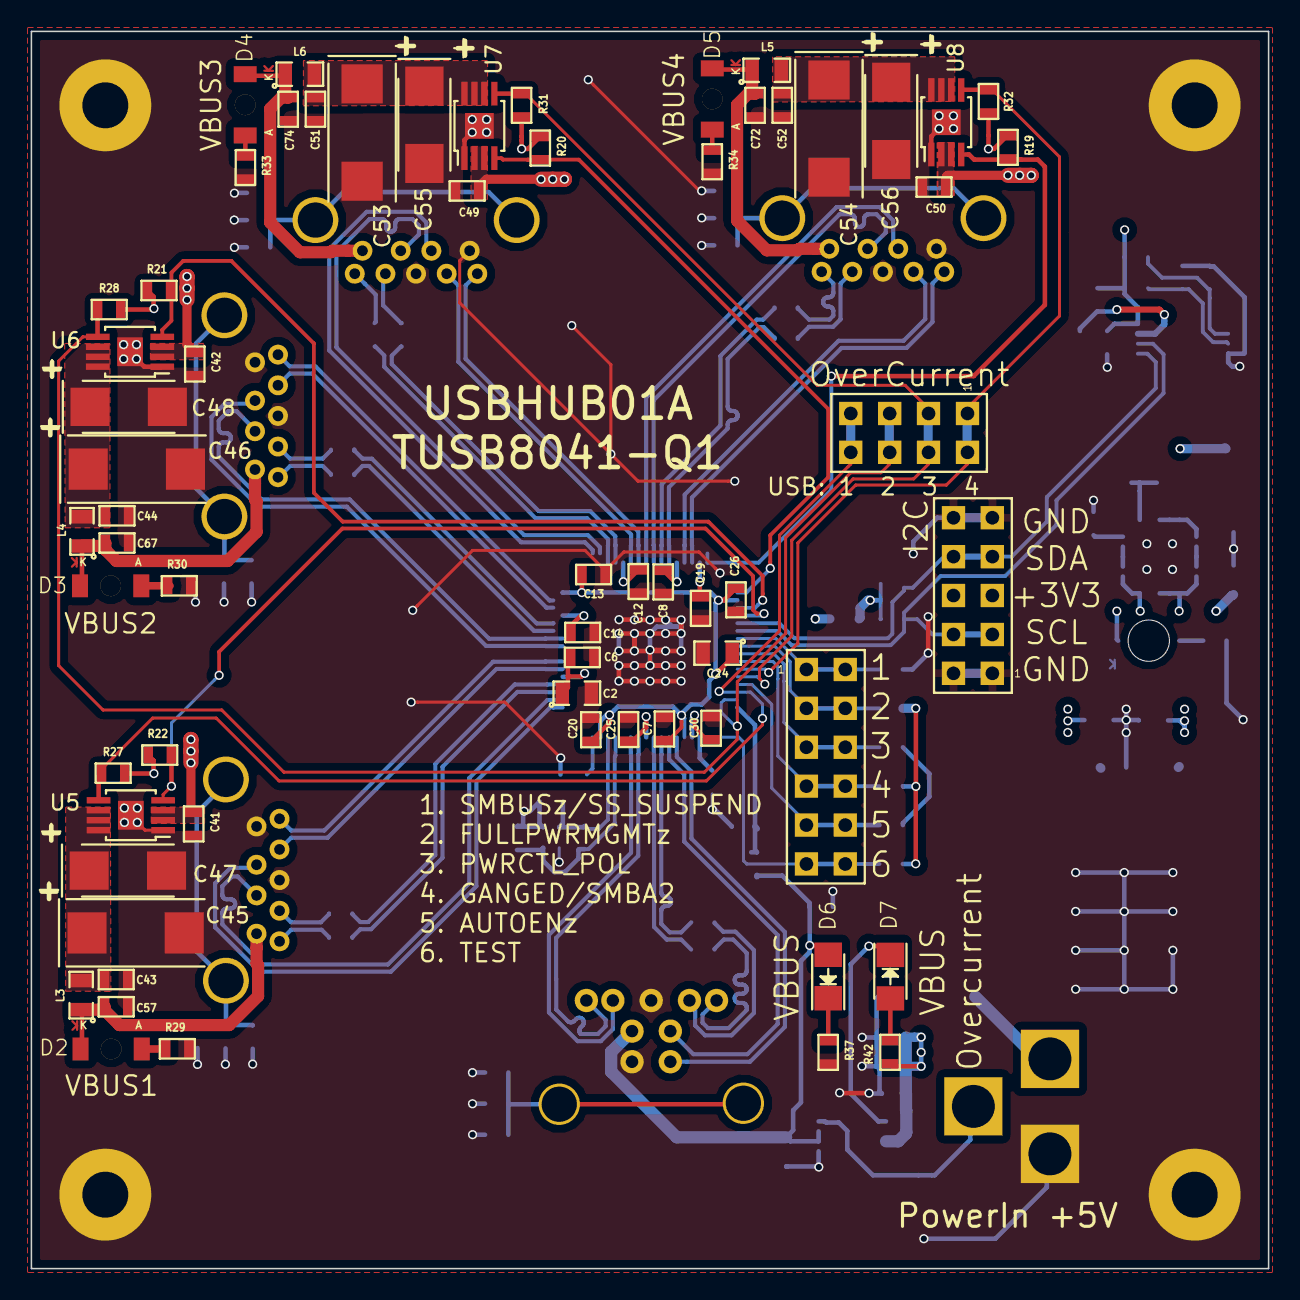
[picture p18: board usbhub01a.kicad_pcb from above]

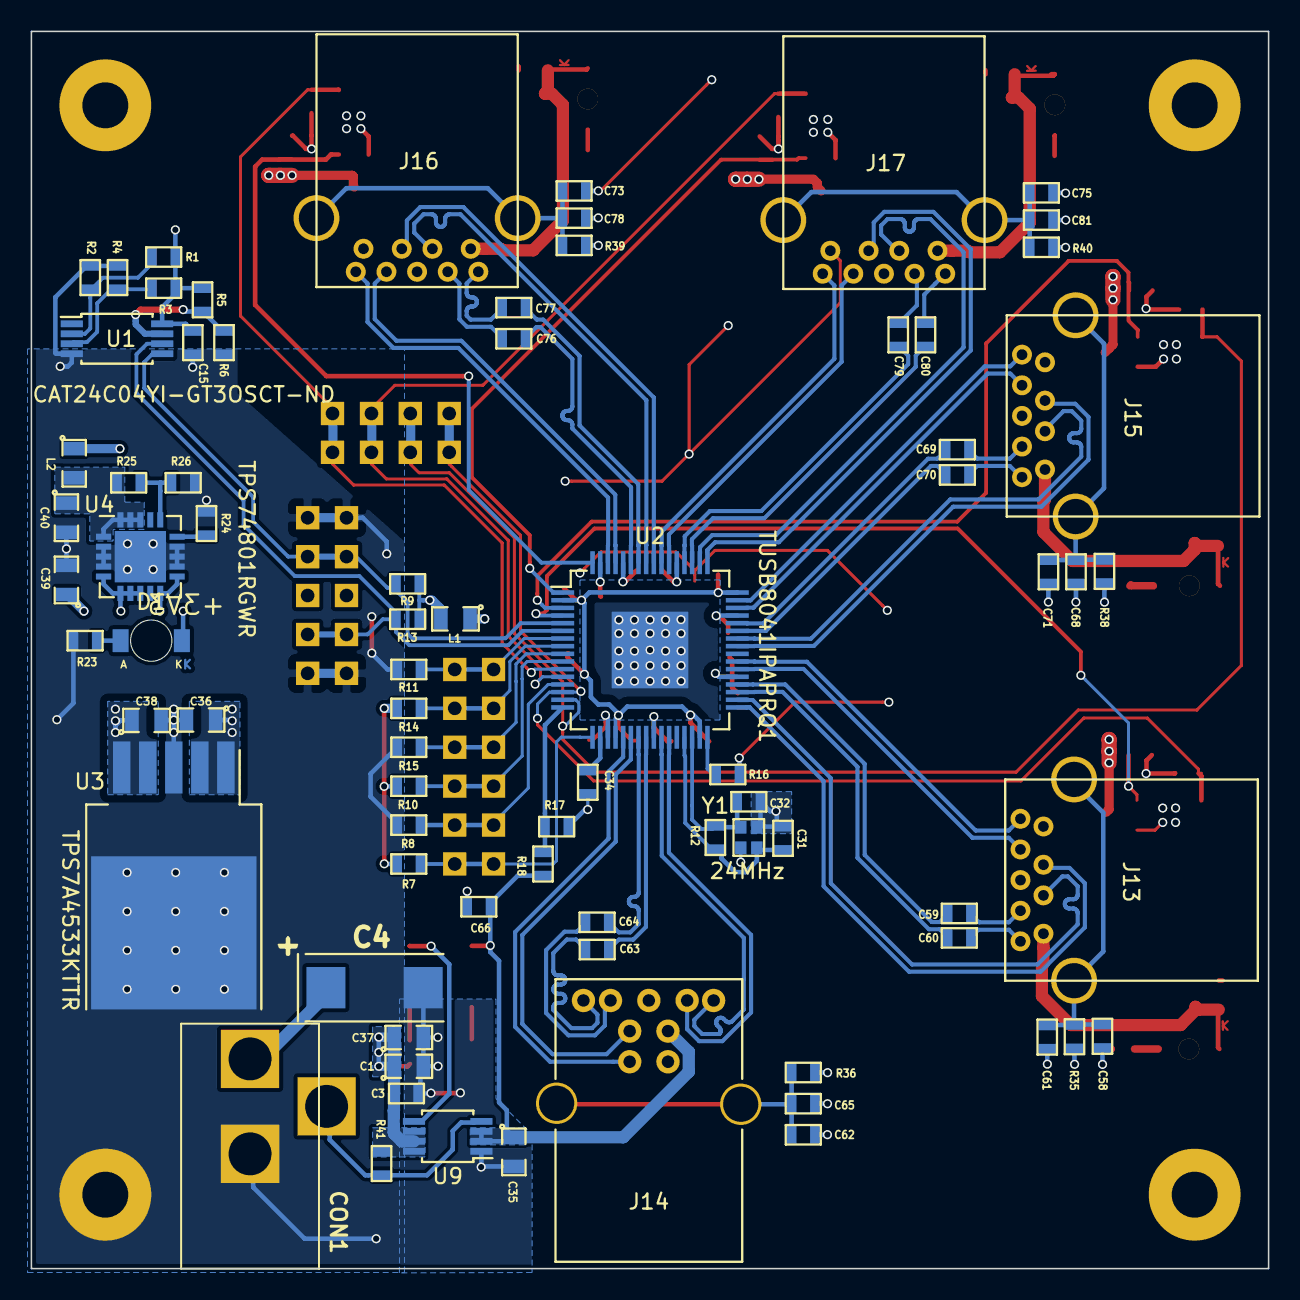
[picture p19: board usbhub01a.kicad_pcb from below]

Board: 4 copper layers, 80.8 x 80.8 mm, 145 parts (77 on the bottom side), 95 nets.

Parts:
C1, C2, C24, C36, C37, C38, C39, C40: 10uF; SMD-0805
C3, C6, C7, C8, C12, C13, C14, C15, C19, C20, C25, C26, C30, C41, C42, C43, C44, C49, C50, C51, C52, C57, C58, C59, C60, C62, C63, C64, C67, C68, C69, C70, C72, C73, C74, C75, C76, C77, C79, C80: 100nF; SMD-0603
C4, C45, C46, C53, C54: 100uF; TantalC_SizeD_Reflow
C31, C32: 18pF; SMD-0603
C34: 1uF; SMD-0603
C35: 1uF; SMD-0805
C47, C48, C55, C56: 47uF; TantalC_SizeC_Reflow
C61, C71, C78, C81: 1nF; SMD-0603
C65: 1nF 2kV; SMD-0603
C66: 10uF; SMD-0603
CON1: PowerIn +5V; DC2,1MM
D1: +3V3; LED_1206
D2: VBUS1; LED_1206
D3: VBUS2; LED_1206
D4: VBUS3; LED_1206
D5: VBUS4; LED_1206
D6: VBUS-UP; LED_1206
D7: LED; LED_1206
J1: OverCurrent; Straight_2x04
J2: Test & Misc Signals; Straight_2x06
J12: I2C; Straight_2x05
J13, J15, J16, J17: USB3_A; USB3_0_A
J14: USB3_B; USB3_0_B
L1, L2, L3, L4, L5, L6: BLM21PG300SN1D; SMD-0805
M1, M2, M3, M4: HOLE; MountingHole_3mm
R1, R3, R24: -; SMD-0603
R2, R4, R6: 1k; SMD-0603
R5: NOPOP; SMD-0603
R7, R8, R10, R11, R14, R15, R19, R20, R21, R22: 4K7; SMD-0603
R9, R13, R17, R41: 10k; SMD-0603
R12, R35, R36, R38, R39, R40: 1M; SMD-0603
R16: 9k53; SMD-0603
R18: 90k9; SMD-0603
R23, R26, R29, R30, R33, R34, R37: 330R; SMD-0603
R25: 1K87; SMD-0603
R27, R28, R31, R32: 10K; SMD-0603
R42: 470R; SMD-0603
U1: CAT24C04YI-GT3OSCT-ND; TSSOP-8_4.4x3mm_Pitch0.65mm
U2: TUSB8041IPAPRQ1; HTQFP-64_10x10mm_Pitch0.5mm
U3: TPS7A4533KTTR; TO-263-5
U4: TPS74801RGWR; QFN-20-1EP_5x5mm_Pitch0.65mm
U5, U6, U7, U8: TPS2001CDGN; MSOP-8-1EP_3x3mm_Pitch0.65mm
U9: AP22811; MSOP-8_3x3mm_Pitch0.65mm
Y1: 24MHz; NX2016HA

Connections:
+1V1: C40.1, L2.2, R25.1, U4.1, U4.18, U4.19, U4.20
+3V3: C15.1, C38.1, C39.1, D1.1, J12.5, J12.6, L1.2, R1.1, R3.1, R5.1, R7.1, R9.1, R10.1, R13.1, R14.1, R19.1, R20.1, R21.1, R22.1, R27.1, R28.1, R31.1, R32.1, U1.8, U3.4, U3.5, U4.5, U4.6, U4.7, U4.8, U4.10, U4.11
+5V: C1.1, C3.1, C4.1, C36.1, C37.1, C41.1, C42.1, C49.1, C50.1, CON1.1, R41.1, R42.1, U3.1, U3.2, U5.2, U5.3, U6.2, U6.3, U7.2, U7.3, U8.2, U8.3, U9.6, U9.7, U9.8
/AUTOENZ_HS_SUS: J2.9, J2.10, R8.1, U2.13
/DN1_VBUS: C43.1, C45.1, C47.1, L3.2, U5.6, U5.7, U5.8
/DN2_VBUS: C44.1, C46.1, C48.1, L4.2, U6.6, U6.7, U6.8
/DN3_VBUS: C51.1, C53.1, C55.1, L6.2, U7.6, U7.7, U7.8
/DN4_VBUS: C52.1, C54.1, C56.1, L5.2, U8.6, U8.7, U8.8
/FULLPWRMGMTZ_SMBA1: J2.3, J2.4, R14.2, U2.8
/GANGED_SMBA2_SH_UP: J2.7, J2.8, R10.2, U2.10
/IO1V1: C2.1, C6.1, C8.1, C12.1, C14.1, C19.1, C25.1, C30.1, L2.1, U2.19, U2.25, U2.37, U2.45, U2.53, U2.60, U2.63
/IO3V3: C7.1, C13.1, C20.1, C24.1, C26.1, L1.1, U2.2, U2.20, U2.31, U2.48
/OVERCUR1Z_TDI: J1.7, J1.8, R27.2, U2.14, U5.5
/OVERCUR2Z_TMS: J1.5, J1.6, R28.2, U2.15, U6.5
/OVERCUR3Z_TCK: J1.3, J1.4, R31.2, U2.12, U7.5
/OVERCUR4Z: J1.1, J1.2, R32.2, U2.11, U8.5
/PWRCTL_POL_TDO: J2.5, J2.6, R15.1, U2.9
/PWRON1_BATEN1: R22.2, U2.4, U5.4
/PWRON2_BATEN2: R21.2, U2.3, U6.4
/PWRON3_BATEN3: R20.2, U2.1, U7.4
/PWRON4_BATEN4: R19.2, U2.64, U8.4
/SCL: J12.3, J12.4, R13.2, U1.6, U2.6
/SDA: J12.7, J12.8, R9.2, U1.5, U2.5
/SMBUSZ_SS_SUS: J2.1, J2.2, R11.1, U2.7
/TEST_TRSTZ: J2.11, J2.12, R7.2, U2.17
/USBPORT/DN1+: C59.2, J13.8
/USBPORT/DN1-: C60.2, J13.9
/USBPORT/DN2+: C69.2, J15.8
/USBPORT/DN2-: C70.2, J15.9
/USBPORT/DN3+: C79.2, J17.8
/USBPORT/DN3-: C80.2, J17.9
/USBPORT/DN4+: C76.2, J16.8
/USBPORT/DN4-: C77.2, J16.9
/USBPORT/SSTX_N: C63.2, J14.5
/USBPORT/SSTX_P: C64.2, J14.6
/USB_DM_DN1+: J13.3, U2.33
/USB_DM_DN1-: J13.2, U2.34
/USB_DM_DN2+: J15.3, U2.41
/USB_DM_DN2-: J15.2, U2.42
/USB_DM_DN3+: J17.3, U2.49
/USB_DM_DN3-: J17.2, U2.50
/USB_DM_DN4+: J16.3, U2.56
/USB_DM_DN4-: J16.2, U2.57
/USB_DM_UP+: J14.3, U2.21
/USB_DM_UP-: J14.2, U2.22
/USB_SSRXM_DN1+: J13.6, U2.38
/USB_SSRXM_DN1-: J13.5, U2.39
/USB_SSRXM_DN2+: J15.6, U2.46
/USB_SSRXM_DN2-: J15.5, U2.47
/USB_SSRXM_DN3+: J17.6, U2.54
/USB_SSRXM_DN3-: J17.5, U2.55
/USB_SSRXM_DN4+: J16.6, U2.61
/USB_SSRXM_DN4-: J16.5, U2.62
/USB_SSRXM_UP+: J14.9, U2.26
/USB_SSRXM_UP-: J14.8, U2.27
/USB_SSTXM_DN1+: C60.1, U2.35
/USB_SSTXM_DN1-: C59.1, U2.36
/USB_SSTXM_DN2+: C70.1, U2.43
/USB_SSTXM_DN2-: C69.1, U2.44
/USB_SSTXM_DN3+: C80.1, U2.51
/USB_SSTXM_DN3-: C79.1, U2.52
/USB_SSTXM_DN4+: C77.1, U2.58
/USB_SSTXM_DN4-: C76.1, U2.59
/USB_SSTXM_UP+: C64.1, U2.23
/USB_SSTXM_UP-: C63.1, U2.24
/USB_VBUS_UP: C35.1, C66.1, D6.2, J14.1, R18.1, U9.2, U9.3
/VBUS1: C57.1, D2.2, J13.1, L3.1
/VBUS2: C67.1, D3.2, J15.1, L4.1
/VBUS3: C74.1, D4.2, J17.1, L6.1
/VBUS4: C72.1, D5.2, J16.1, L5.1
GND: C1.2, C2.2, C3.2, C4.2, C6.2, C7.2, C8.2, C12.2, C13.2, C14.2, C15.2, C19.2, C20.2, C24.2, C25.2, C26.2, C30.2, C31.2, C32.2, C34.2, C35.2, C36.2, C37.2, C38.2, C39.2, C40.2, C41.2, C42.2, C43.2, C44.2, C45.2, C46.2, C47.2, C48.2, C49.2, C50.2, C51.2, C52.2, C53.2, C54.2, C55.2, C56.2, C57.2, C58.2, C61.2, C62.2, C65.2, C66.2, C67.2, C68.2, C71.2, C72.2, C73.2, C74.2, C75.2, C78.2, C81.2, CON1.2, J12.1, J12.2, J12.9, J12.10, J13.4, J13.7, J14.4, J14.7, J15.4, J15.7, J16.4, J16.7, J17.4, J17.7, M1.1, M2.1, M3.1, M4.1, R2.2, R4.2, R6.2, R8.2, R11.2, R15.2, R16.2, R17.2, R23.2, R24.2, R26.2, R29.2, R30.2, R33.2, R34.2, R35.2, R36.2, R37.2, R38.2, R39.2, R40.2, U1.4, U2.65, U3.3, U4.2, U4.3, U4.4, U4.12, U4.13, U4.14, U4.21, U5.1, U5.9, U6.1, U6.9, U7.1, U7.9, U8.1, U8.9, U9.1, Y1.2, Y1.4
unnamed: C31.1, R12.2, U2.29, Y1.3
unnamed: C32.1, R12.1, U2.30, Y1.1
unnamed: C34.1, U2.18
unnamed: C58.1, C61.1, J13.10, R35.1
unnamed: C62.1, C65.1, J14.10, R36.1
unnamed: C68.1, C71.1, J15.10, R38.1
unnamed: C73.1, C78.1, J16.10, R39.1
unnamed: C75.1, C81.1, J17.10, R40.1
unnamed: CON1.3, R41.2, U9.4
unnamed: D1.2, R23.1
unnamed: D2.1, R29.1
unnamed: D3.1, R30.1
unnamed: D4.1, R33.1
unnamed: D5.1, R34.1
unnamed: D6.1, R37.1
unnamed: D7.1, U9.5
unnamed: D7.2, R42.2
unnamed: R1.2, R2.1, U1.2
unnamed: R3.2, R4.1, U1.3
unnamed: R5.2, R6.1, U1.7
unnamed: R16.1, U2.32
unnamed: R17.1, R18.2, U2.16
unnamed: R24.1, U4.15
unnamed: R25.2, R26.1, U4.16
