cernohorsky/Modules/CommSerial/SPIEX01A/SPI_Expander.kicad_pcb

## KiCad design CommSerial/SPIEX01A/SPI_Expander.kicad_pcb (2018-01-28)

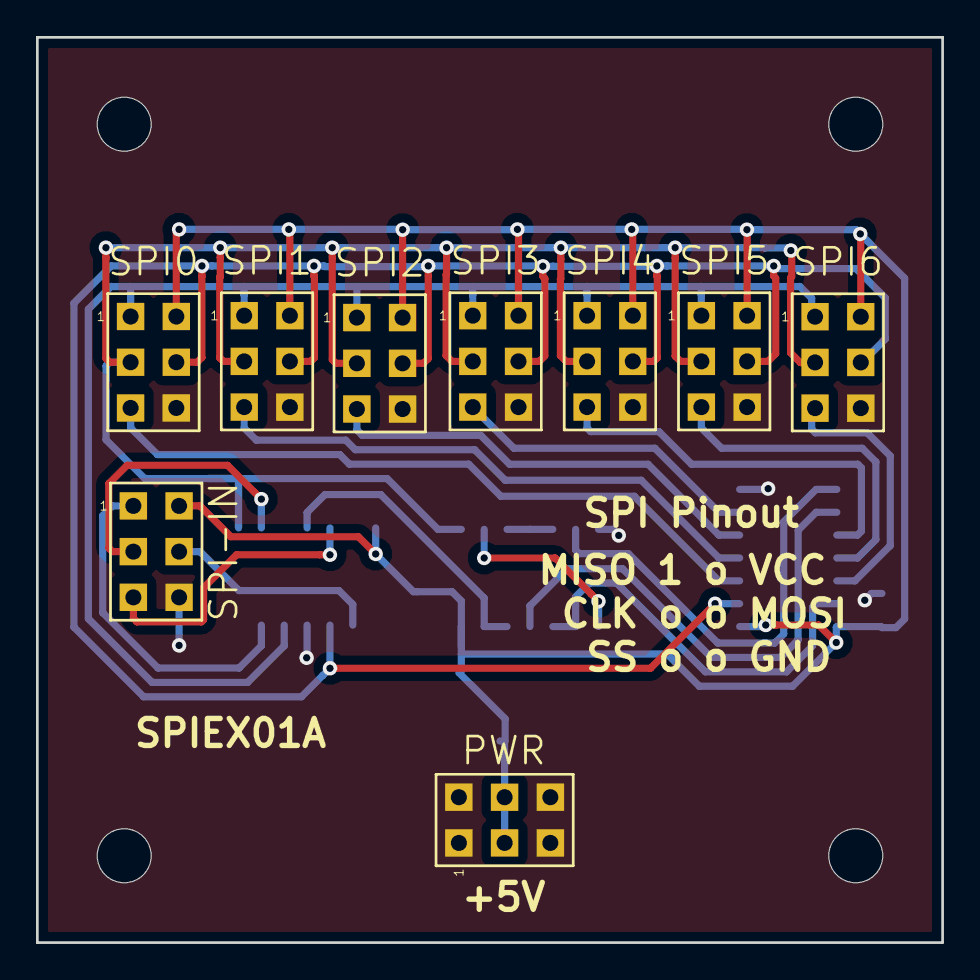
[picture p23: board SPI_Expander.kicad_pcb from above]

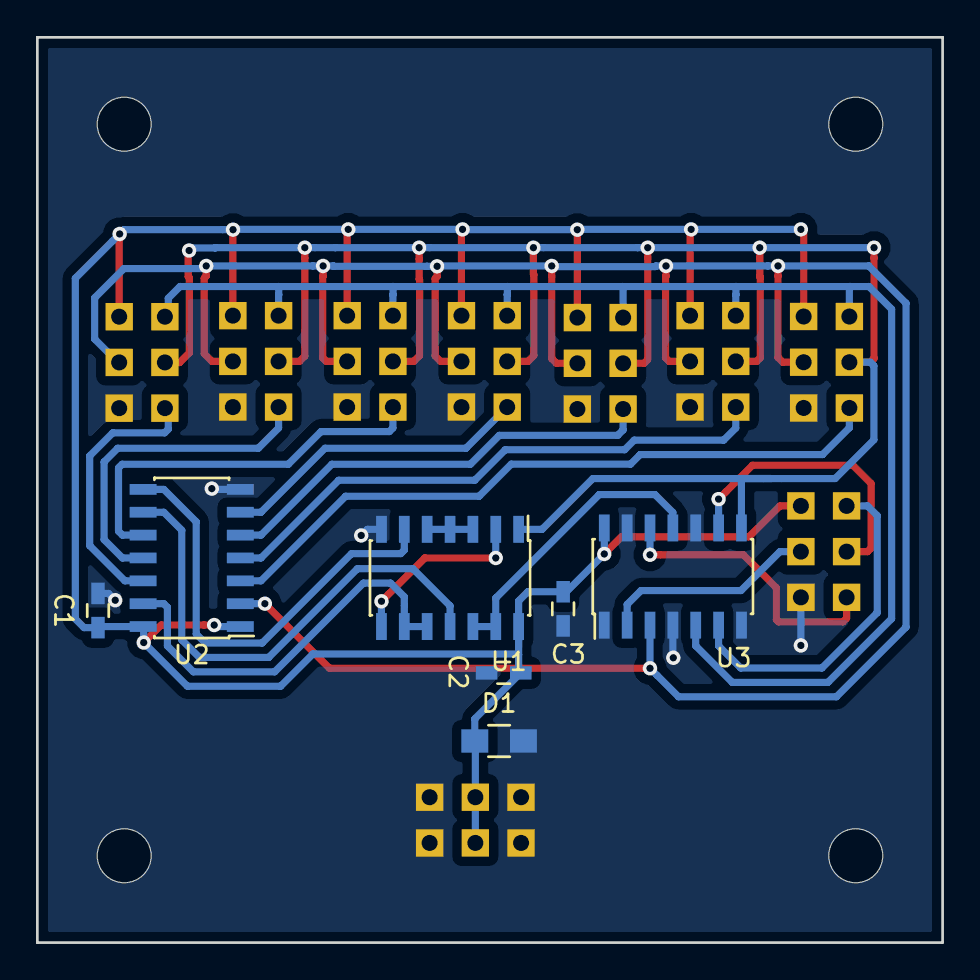
[picture p24: board SPI_Expander.kicad_pcb from below]

Board: 2 copper layers, 50.3 x 50.3 mm, 20 parts (11 on the bottom side), 22 nets.

Parts:
C1, C2, C3: 100n; C_0603_HandSoldering
D1: D; R_0805_HandSoldering
J1: PWR; Straight_2x03
P1: SPI-IN; Straight_2x03
P2: SPI3; Straight_2x03
P3: SPI0; Straight_2x03
P4: SPI4; Straight_2x03
P5: SPI1; Straight_2x03
P6: SPI5; Straight_2x03
P7: SPI2; Straight_2x03
P8: SPI6; Straight_2x03
P10, P11, P12, P13: CONN_01X01; MountingHole_3mm
U1: 74HC00; SOIC-14_3.9x8.7mm_Pitch1.27mm
U2: 74HC164; SOIC-14_3.9x8.7mm_Pitch1.27mm
U3: 74HC125; SOIC-14_3.9x8.7mm_Pitch1.27mm

Connections:
/CLK: P2.3, P3.3, P4.3, P5.3, P6.3, P7.3, P8.3, U1.1, U3.8
/CLK-IN: P1.3, U3.9
/MISO: P2.1, P3.1, P4.1, P5.1, P6.1, P7.1, P8.1, U3.5
/MISO-OUT: P1.1, U3.6
/MOSI: P2.4, P3.4, P4.4, P5.4, P6.4, P7.4, P8.4, U2.2, U3.3
/MOSI-IN: P1.4, U3.2
/SS: U1.12, U1.13, U3.11
/SS0: P3.5, U2.3
/SS1: P5.5, U2.4
/SS2: P7.5, U2.5
/SS3: P2.5, U2.6
/SS4: P4.5, U2.10
/SS5: P6.5, U2.11
/SS6: P8.5, U2.12
/SS-IN: P1.5, U3.12
GND: C1.2, C2.2, C3.2, D1.2, J1.1, J1.2, J1.5, J1.6, P1.6, P2.6, P3.6, P4.6, P5.6, P6.6, P7.6, P8.6, P10.1, P11.1, P12.1, P13.1, U1.7, U2.7, U3.1, U3.4, U3.7, U3.10, U3.13
unnamed: U1.2, U1.8
unnamed: U1.3, U1.4, U1.5
unnamed: U1.6, U2.8
unnamed: U1.9, U1.10, U2.13
unnamed: U1.11, U2.9
VCC: C1.1, C2.1, C3.1, D1.1, J1.3, J1.4, P1.2, P2.2, P3.2, P4.2, P5.2, P6.2, P7.2, P8.2, U1.14, U2.1, U2.14, U3.14
