cernohorsky/Modules/(commit log)

2017-08-21 Vyhozený vypínač, přidaný "Distribution Load Switch"
    [power.sch, usbhub01a.kicad_pcb, usbhub01a.sch]
2017-08-21 Přidání tantalového kondenzátoru na +5V větev
    [power.sch, usbhub01a.kicad_pcb]
2018-01-28 USB-Hub-funkcni finalni verze
    [power.sch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]
2018-06-07 Prvni vykop
    [NixieClock01A.kicad_pcb, NixieClock01A.sch]
2018-06-08 LM3478, ESP8266 layout
    [NixieClock01A.kicad_pcb, NixieClock01A.sch]
2018-06-09 ESP8266, TPS63030 - Final
    [ESP8266-2018-06-09-09-58-21.sch, ESP8266.kicad_pcb, ESP8266.sch]
2018-06-09 TUSB8041IPAPRQ1 - Final - Verified design
    [downstream-2018-06-09-10-06-41.sch, power-2018-06-09-10-06-41.sch, usbhub01a-2018-06-09-10-06-41.sch, usbport-2018-06-09-10-06-41.sch]
2018-06-12 Nixie layout
    [NixieClock01A.kicad_pcb, NixieClock01A.sch]
2018-06-13 Power supplies layout
    [NixieClock01A.kicad_pcb, NixieClock01A.sch]
